que-bert/clock-radio/cad/Board Holder.step

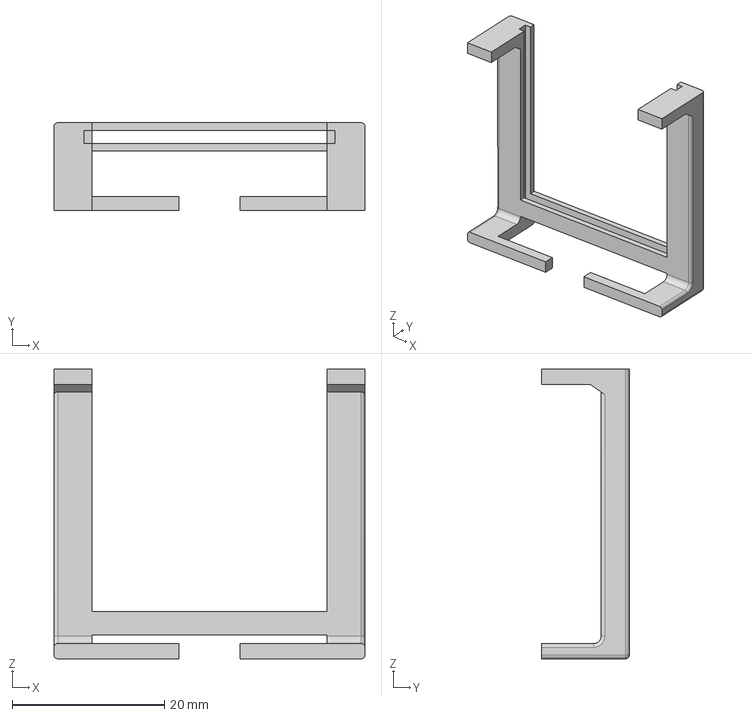
[picture p1: CAD file, 2026-07-31]
cad/Board Holder.step
40.8 x 11.5 x 38.0 mm
