que-bert/clock-radio/cad/Rat_Clock_Final.step

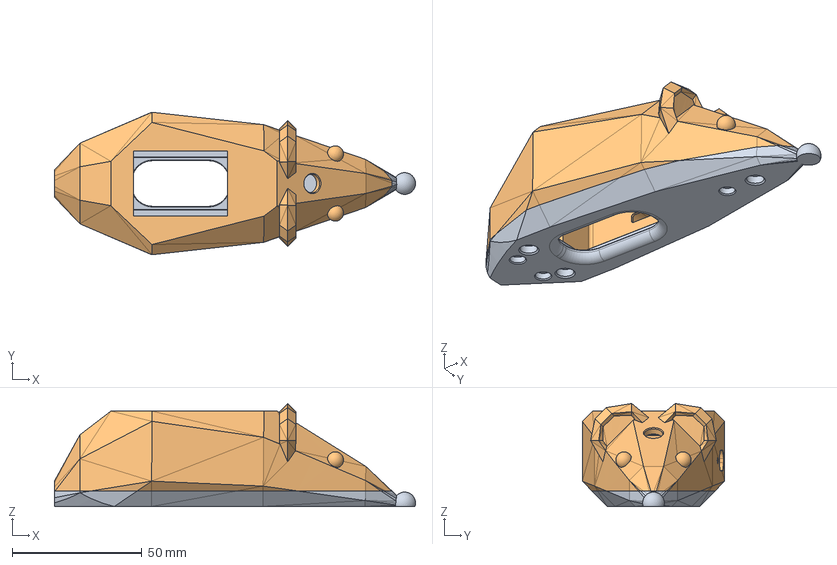
[picture p2: CAD file, 2026-07-31]
cad/Rat_Clock_Final.step
139.4 x 55.0 x 39.8 mm
