que-bert/clock-radio/kicad/clock-radio.kicad_pcb

## KiCad design kicad/clock-radio.kicad_pcb (2026-06-23)

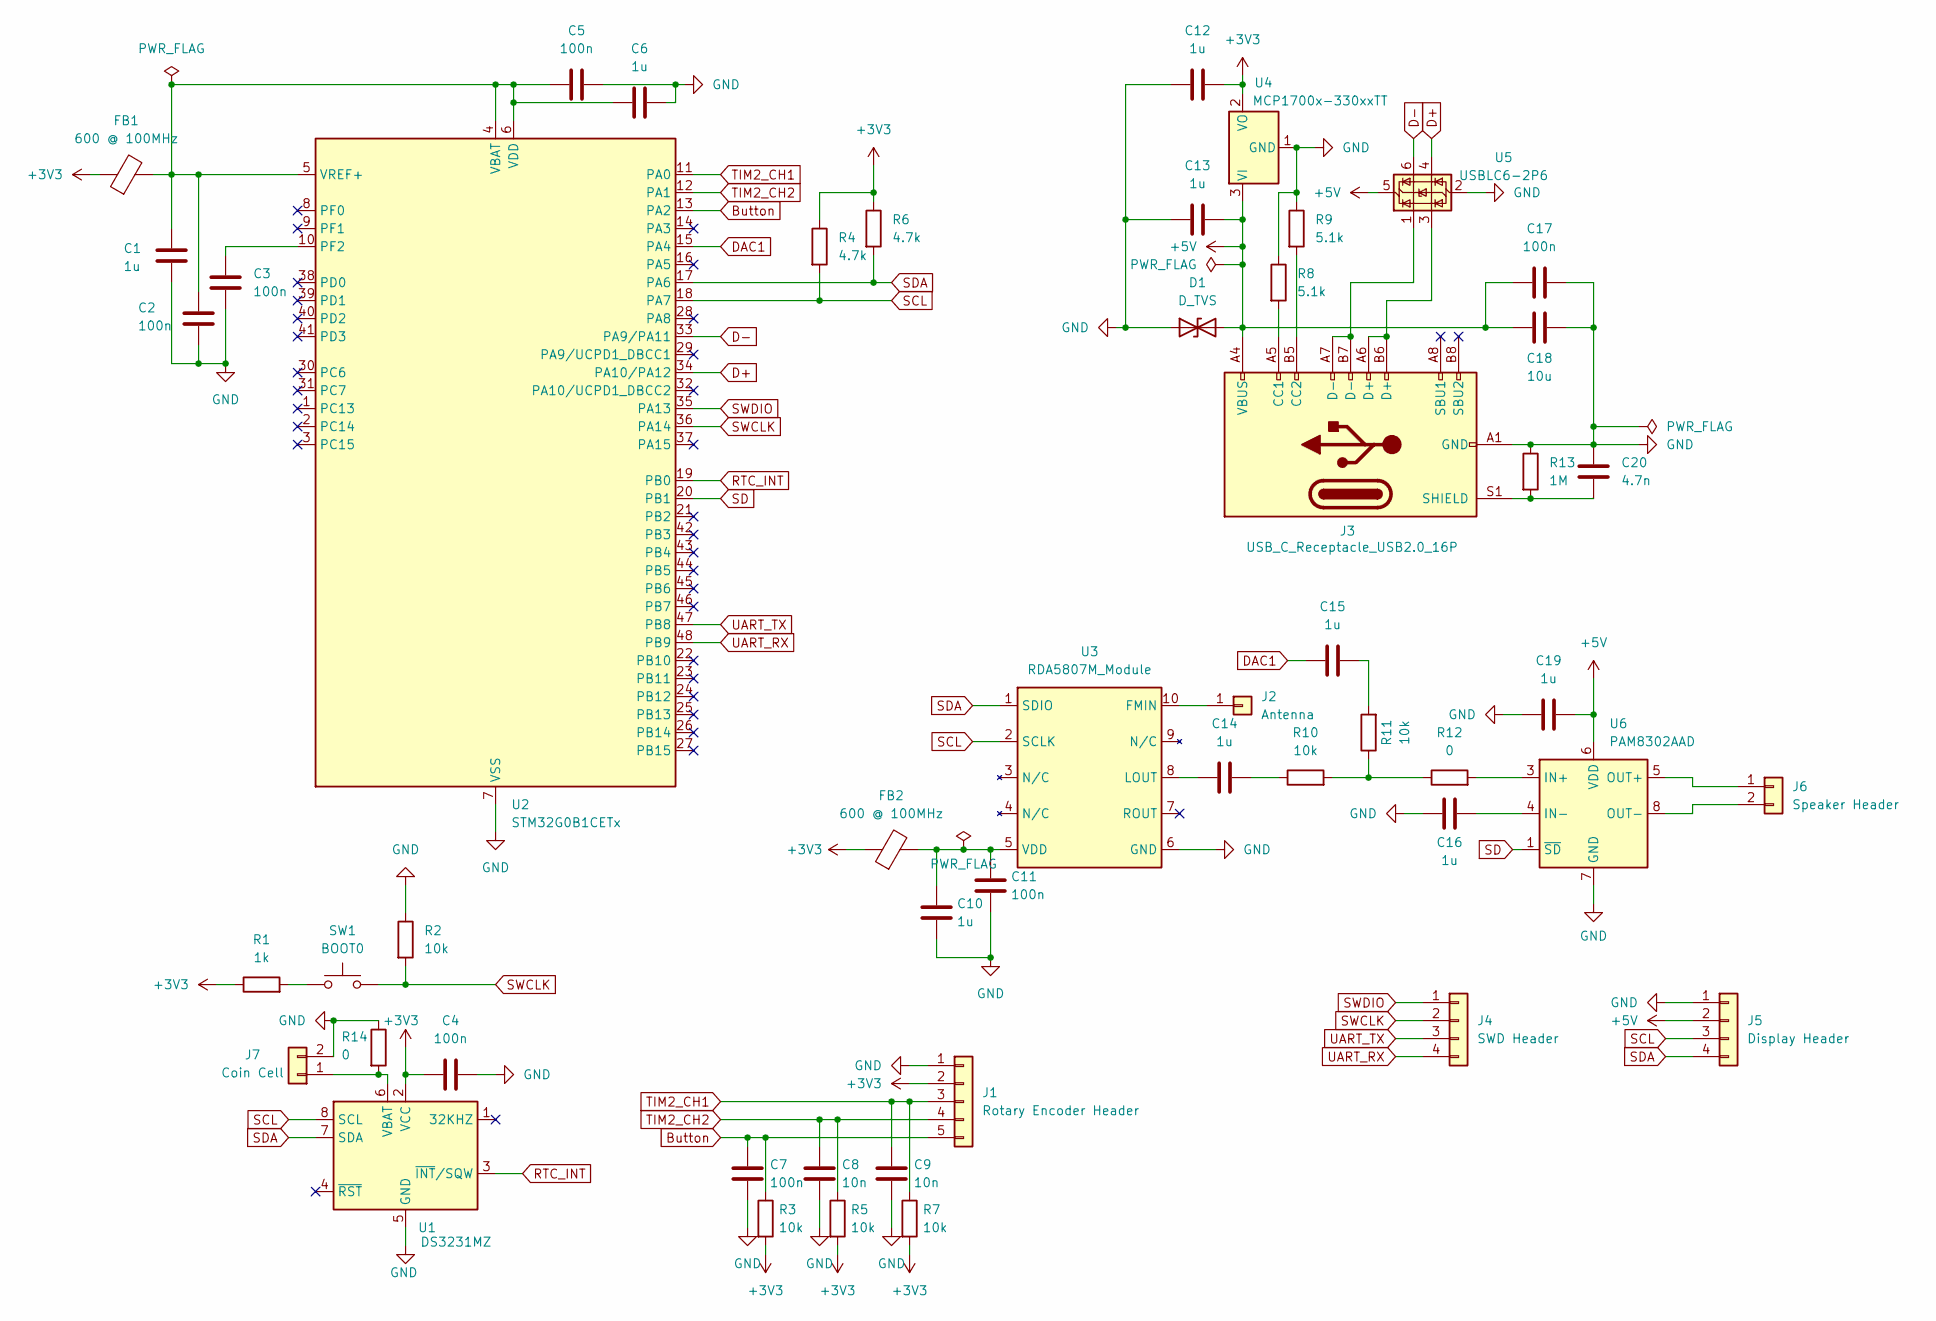
[picture p3: schematic clock-radio.kicad_sch]

Parts:
C1, C6, C10, C12, C13, C14, C15, C16, C19: 1u; C_0402_1005Metric_Pad0.74x0.62mm_HandSolder
C2, C3, C4, C5, C7, C11, C17: 100n; C_0402_1005Metric_Pad0.74x0.62mm_HandSolder
C8, C9: 10n; C_0402_1005Metric_Pad0.74x0.62mm_HandSolder
C18: 10u; C_0402_1005Metric_Pad0.74x0.62mm_HandSolder
C20: 4.7n; C_0402_1005Metric_Pad0.74x0.62mm_HandSolder
D1: D_TVS; D_SMA-SMB_Universal_Handsoldering
FB1, FB2: 600 @ 100MHz; C_0603_1608Metric_Pad1.08x0.95mm_HandSolder
J1: Rotary Encoder Header; PinSocket_1x05_P2.54mm_Vertical
J2: Antenna; SolderWire-0.75sqmm_1x01_D1.25mm_OD2.3mm
J3: USB_C_Receptacle_USB2.0_16P; USB_C_Receptacle_HCTL_HC-TYPE-C-16P-01A
J4: SWD Header; PinSocket_1x04_P2.54mm_Vertical
J5: Display Header; PinSocket_1x04_P2.54mm_Vertical
J6: Speaker Header; PinSocket_1x02_P2.54mm_Vertical
J7: Coin Cell; PinSocket_1x02_P2.54mm_Vertical
R1: 1k; R_0402_1005Metric_Pad0.72x0.64mm_HandSolder
R2, R3, R5, R7, R10, R11: 10k; R_0402_1005Metric_Pad0.72x0.64mm_HandSolder
R4, R6: 4.7k; R_0402_1005Metric_Pad0.72x0.64mm_HandSolder
R8, R9: 5.1k; R_0402_1005Metric_Pad0.72x0.64mm_HandSolder
R12, R14: 0; R_0402_1005Metric_Pad0.72x0.64mm_HandSolder
R13: 1M; R_0402_1005Metric_Pad0.72x0.64mm_HandSolder
SW1: BOOT0; SW_SPST_B3U-1000P
U1: DS3231MZ; SOIC-8_3.9x4.9mm_P1.27mm
U2: STM32G0B1CETx; LQFP-48_7x7mm_P0.5mm
U3: RDA5807M_Module; RDA5807M_Module_SM
U4: MCP1700x-330xxTT; SOT-23
U5: USBLC6-2P6; SOT-666
U6: PAM8302AAD; MSOP-8_3x3mm_P0.65mm

Connections:
+3V3: C4.1, C12.2, FB1.1, FB2.1, J1.2, R1.1, R3.2, R4.1, R5.2, R6.1, R7.2, U1.2 (VCC), U4.2 (VO); also elsewhere on the board
+5V: C13.2, C17.1, C18.1, C19.2, D1.2 (A2), J3.A4 (VBUS), J3.A9 (VBUS), J3.B4 (VBUS), J3.B9 (VBUS), J5.2, U4.3 (VI), U5.5 (VBUS), U6.6 (VDD)
Button: C7.1, J1.5, R3.1, U2.13 (PA2)
D+: U2.34 (PA10/PA12), U5.4 (I/O2)
D-: U2.33 (PA9/PA11), U5.6 (I/O1)
DAC1: C15.1, U2.15 (PA4)
GND: C1.1, C2.1, C3.1, C4.2, C5.2, C6.2, C7.2, C8.2, C9.2, C10.2, C11.2, C12.1, C13.1, C16.2, C17.2, C18.2, C19.1, C20.1, D1.1 (A1), J1.1, J3.A1 (GND), J3.A12 (GND), J3.B1 (GND), J3.B12 (GND), J5.1, J7.2, R2.1, R8.1, R9.1, R13.1, R14.1, U1.5 (GND), U2.7 (VSS), U3.6 (GND), U4.1 (GND), U5.2 (GND), U6.7 (GND); also elsewhere on the board
unnamed: C14.2, R10.1
unnamed: C15.2, R11.2
unnamed: J2.1, U3.10 (FMIN)
unnamed: J3.A5 (CC1), R8.2
unnamed: J3.B5 (CC2), R9.2
unnamed: J3.A6 (D+), J3.B6 (D+), U5.3 (I/O2)
unnamed: J3.A7 (D-), J3.B7 (D-), U5.1 (I/O1)
unnamed: C20.2, J3.S1 (SHIELD), R13.2
unnamed: J6.1, U6.5 (OUT+)
unnamed: J6.2, U6.8 (OUT-)
unnamed: J7.1, R14.2, U1.6 (VBAT)
unnamed: R1.2, SW1.1
unnamed: R10.2, R11.1, R12.1
unnamed: C3.2, U2.10 (PF2)
unnamed: C1.2, C2.2, C5.1, C6.1, FB1.2, U2.4 (VBAT), U2.5 (VREF+), U2.6 (VDD)
unnamed: C14.1, U3.8 (LOUT)
unnamed: C10.1, C11.1, FB2.2, U3.5 (VDD)
unnamed: R12.2, U6.3 (IN+)
unnamed: C16.1, U6.4 (IN-)
RTC_INT: U1.3 (~INT/SQW), U2.19 (PB0)
SCL: J5.3, R4.2, U1.8 (SCL), U2.18 (PA7), U3.2 (SCLK)
SD: U2.20 (PB1), U6.1 (~SD)
SDA: J5.4, R6.2, U1.7 (SDA), U2.17 (PA6), U3.1 (SDIO)
SWCLK: J4.2, R2.2, SW1.2, U2.36 (PA14)
SWDIO: J4.1, U2.35 (PA13)
TIM2_CH1: C9.1, J1.3, R7.1, U2.11 (PA0)
TIM2_CH2: C8.1, J1.4, R5.1, U2.12 (PA1)
UART_RX: J4.4, U2.48 (PB9)
UART_TX: J4.3, U2.47 (PB8)

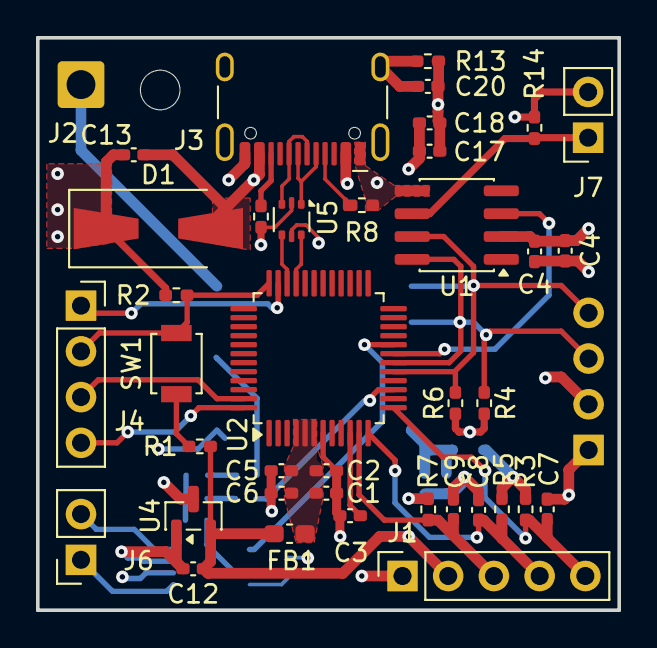
[picture p4: board clock-radio.kicad_pcb from above]

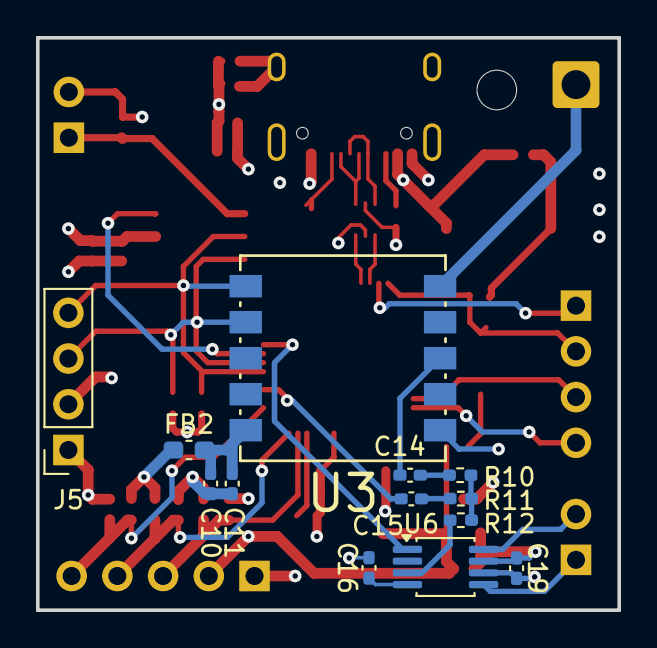
[picture p5: board clock-radio.kicad_pcb from below]

Board: 4 copper layers, 32.3 x 31.8 mm, 52 parts (13 on the bottom side), 36 nets.

Other parts of the board:
C4#2: 100n; C_0402_1005Metric_Pad0.74x0.62mm_HandSolder

Their connections:
+3V3: C4#2.2; also elsewhere on the board
GND: C4#2.1; also elsewhere on the board
