que-bert/clock-radio/firmware/Core/Src/main.c

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
/* Includes ------------------------------------------------------------------*/
#include "main.h"

/* USER CODE BEGIN Includes */
#include "ui.h"
#include "usb_device.h"
#include "console.h"
/* USER CODE END Includes */

DAC_HandleTypeDef hdac1;
DMA_HandleTypeDef hdma_dac1_ch1;

I2C_HandleTypeDef hi2c2;

TIM_HandleTypeDef htim2;
TIM_HandleTypeDef htim6;

UART_HandleTypeDef huart3;

PCD_HandleTypeDef hpcd_USB_DRD_FS;

void SystemClock_Config(void);
static void MX_GPIO_Init(void);
static void MX_DMA_Init(void);
static void MX_DAC1_Init(void);
static void MX_I2C2_Init(void);
static void MX_TIM2_Init(void);
static void MX_TIM6_Init(void);
static void MX_USART3_UART_Init(void);
static void MX_USB_DRD_FS_PCD_Init(void);
/* USER CODE BEGIN 0 */
/* Jump to the ROM bootloader (USB DFU). Callable from the running app
 * (console "dfu" command) as well as early boot: the USB peripheral is
 * force-reset so the bootloader finds virgin hardware even if the app
 * was enumerated, and IRQs are masked/cleared via NVIC, not PRIMASK -
 * the bootloader needs interrupts deliverable once it sets its own up. */
void dfu_jump(void)
{
  uint32_t boot_msp   = *(volatile uint32_t *)0x1FFF0000u;  /* system memory */
  uint32_t boot_entry = *(volatile uint32_t *)0x1FFF0004u;

  __HAL_RCC_USB_FORCE_RESET();
  __HAL_RCC_USB_RELEASE_RESET();
  HAL_RCC_DeInit();
  SysTick->CTRL = 0; SysTick->LOAD = 0; SysTick->VAL = 0;
  NVIC->ICER[0U] = 0xFFFFFFFFu;
  NVIC->ICPR[0U] = 0xFFFFFFFFu;
  __HAL_RCC_SYSCFG_CLK_ENABLE();
  __HAL_SYSCFG_REMAPMEMORY_SYSTEMFLASH();
  __set_MSP(boot_msp);
  ((void (*)(void))boot_entry)();
}

/* Enter the ROM bootloader when the encoder button is held at power-up.
 * Runs before peripheral init, so it configures the one pin it needs
 * itself. */
static void dfu_enter_if_button_held(void)
{
  GPIO_InitTypeDef gi = {0};
  __HAL_RCC_GPIOA_CLK_ENABLE();
  gi.Pin  = ENC_BUTTON_Pin;
  gi.Mode = GPIO_MODE_INPUT;
  gi.Pull = GPIO_PULLUP;
  HAL_GPIO_Init(ENC_BUTTON_GPIO_Port, &gi);

  HAL_Delay(50);                       /* pull-up settle + debounce */
  if (HAL_GPIO_ReadPin(ENC_BUTTON_GPIO_Port, ENC_BUTTON_Pin) != GPIO_PIN_RESET)
    return;

  dfu_jump();
}
/* USER CODE END 0 */

/**
  * @brief  The application entry point.
  * @retval int
  */
int main(void)
{

  /* USER CODE BEGIN 1 */
  /* After a dfu-util ":leave" the ROM bootloader jumps here with VTOR
   * still pointing at its own vector table, so every interrupt (SysTick,
   * USB, ...) would land in ROM code. Reclaim the vectors first. */
  SCB->VTOR = FLASH_BASE;
  /* USER CODE END 1 */

  /* MCU Configuration--------------------------------------------------------*/

  /* Reset of all peripherals, Initializes the Flash interface and the Systick. */
  HAL_Init();

  /* Configure the system clock */
  SystemClock_Config();

  /* USER CODE BEGIN SysInit */
  dfu_enter_if_button_held();
  /* USER CODE END SysInit */

  /* Initialize all configured peripherals */
  MX_GPIO_Init();
  MX_DMA_Init();
  MX_DAC1_Init();
  MX_I2C2_Init();
  MX_TIM2_Init();
  MX_TIM6_Init();
  MX_USART3_UART_Init();
  MX_USB_DRD_FS_PCD_Init();
  /* USER CODE BEGIN 2 */
  ui_init();
  MX_USB_Device_Init();        /* CDC command console on the USB port */
  /* USER CODE END 2 */

  /* Infinite loop */
  /* USER CODE BEGIN WHILE */
  while (1)
  {
    /* USER CODE END WHILE */

    /* USER CODE BEGIN 3 */
    ui_tick();
    console_tick();
  }
  /* USER CODE END 3 */
}

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
