que-bert/clock-radio/firmware/clock-radio.ioc

Mcu.UserName=STM32G0B1CETx
PA0.Signal=S_TIM2_CH1_ETR
PA1.Signal=S_TIM2_CH2
PA13.Signal=SYS_SWDIO
PA14-BOOT0.Signal=SYS_SWCLK
PA2.GPIO_Label=ENC_BUTTON
PA2.Signal=GPIO_Input
PA4.Signal=COMP_DAC11_group
PA6.Signal=I2C2_SDA
PA7.Signal=I2C2_SCL
PB0.GPIO_Label=RTC_INT
PB0.Signal=GPXTI0
PB1.GPIO_Label=AMP_SD
PB1.Signal=GPIO_Output
PB8.Signal=USART3_TX
PB9.Signal=USART3_RX
