que-bert/clock-radio/firmware/Core/Inc/main.h

#define ENC_BUTTON_Pin GPIO_PIN_2
#define ENC_BUTTON_GPIO_Port GPIOA
#define RTC_INT_Pin GPIO_PIN_0
#define RTC_INT_GPIO_Port GPIOB
#define RTC_INT_EXTI_IRQn EXTI0_1_IRQn
#define AMP_SD_Pin GPIO_PIN_1
#define AMP_SD_GPIO_Port GPIOB
