que-bert/clock-radio/firmware/App/Src/oled.c

/* oled.c - SH1106 driver (I2C, page-addressed) with a 5x7 font */
#include "oled.h"
#include "bsp.h"

#define SH1106_COL_OFFSET 2          /* 132-col RAM, 128 visible */

static uint8_t fb[OLED_W * OLED_H / 8];   /* 8 pages x 128 cols */

/* ---- 5x7 font, ASCII 0x20..0x7E, 5 column-bytes per glyph (LSB=top) ---- */
static const uint8_t font5x7[][5] = {
    {0x00,0x00,0x00,0x00,0x00}, /* sp */ {0x00,0x00,0x5F,0x00,0x00}, /* ! */
    {0x00,0x07,0x00,0x07,0x00}, /* " */  {0x14,0x7F,0x14,0x7F,0x14}, /* # */
    {0x24,0x2A,0x7F,0x2A,0x12}, /* $ */  {0x23,0x13,0x08,0x64,0x62}, /* % */
    {0x36,0x49,0x55,0x22,0x50}, /* & */  {0x00,0x05,0x03,0x00,0x00}, /* ' */
    {0x00,0x1C,0x22,0x41,0x00}, /* ( */  {0x00,0x41,0x22,0x1C,0x00}, /* ) */
    {0x14,0x08,0x3E,0x08,0x14}, /* * */  {0x08,0x08,0x3E,0x08,0x08}, /* + */
    {0x00,0x50,0x30,0x00,0x00}, /* , */  {0x08,0x08,0x08,0x08,0x08}, /* - */
    {0x00,0x60,0x60,0x00,0x00}, /* . */  {0x20,0x10,0x08,0x04,0x02}, /* / */
    {0x3E,0x51,0x49,0x45,0x3E}, /* 0 */  {0x00,0x42,0x7F,0x40,0x00}, /* 1 */
    {0x42,0x61,0x51,0x49,0x46}, /* 2 */  {0x21,0x41,0x45,0x4B,0x31}, /* 3 */
    {0x18,0x14,0x12,0x7F,0x10}, /* 4 */  {0x27,0x45,0x45,0x45,0x39}, /* 5 */
    {0x3C,0x4A,0x49,0x49,0x30}, /* 6 */  {0x01,0x71,0x09,0x05,0x03}, /* 7 */
    {0x36,0x49,0x49,0x49,0x36}, /* 8 */  {0x06,0x49,0x49,0x29,0x1E}, /* 9 */
    {0x00,0x36,0x36,0x00,0x00}, /* : */  {0x00,0x56,0x36,0x00,0x00}, /* ; */
    {0x08,0x14,0x22,0x41,0x00}, /* < */  {0x14,0x14,0x14,0x14,0x14}, /* = */
    {0x00,0x41,0x22,0x14,0x08}, /* > */  {0x02,0x01,0x51,0x09,0x06}, /* ? */
    {0x32,0x49,0x79,0x41,0x3E}, /* @ */  {0x7E,0x11,0x11,0x11,0x7E}, /* A */
    {0x7F,0x49,0x49,0x49,0x36}, /* B */  {0x3E,0x41,0x41,0x41,0x22}, /* C */
    {0x7F,0x41,0x41,0x22,0x1C}, /* D */  {0x7F,0x49,0x49,0x49,0x41}, /* E */
    {0x7F,0x09,0x09,0x09,0x01}, /* F */  {0x3E,0x41,0x49,0x49,0x7A}, /* G */
    {0x7F,0x08,0x08,0x08,0x7F}, /* H */  {0x00,0x41,0x7F,0x41,0x00}, /* I */
    {0x20,0x40,0x41,0x3F,0x01}, /* J */  {0x7F,0x08,0x14,0x22,0x41}, /* K */
    {0x7F,0x40,0x40,0x40,0x40}, /* L */  {0x7F,0x02,0x0C,0x02,0x7F}, /* M */
    {0x7F,0x04,0x08,0x10,0x7F}, /* N */  {0x3E,0x41,0x41,0x41,0x3E}, /* O */
    {0x7F,0x09,0x09,0x09,0x06}, /* P */  {0x3E,0x41,0x51,0x21,0x5E}, /* Q */
    {0x7F,0x09,0x19,0x29,0x46}, /* R */  {0x46,0x49,0x49,0x49,0x31}, /* S */
    {0x01,0x01,0x7F,0x01,0x01}, /* T */  {0x3F,0x40,0x40,0x40,0x3F}, /* U */
    {0x1F,0x20,0x40,0x20,0x1F}, /* V */  {0x3F,0x40,0x38,0x40,0x3F}, /* W */
    {0x63,0x14,0x08,0x14,0x63}, /* X */  {0x07,0x08,0x70,0x08,0x07}, /* Y */
    {0x61,0x51,0x49,0x45,0x43}, /* Z */  {0x00,0x7F,0x41,0x41,0x00}, /* [ */
    {0x02,0x04,0x08,0x10,0x20}, /* \ */  {0x00,0x41,0x41,0x7F,0x00}, /* ] */
    {0x04,0x02,0x01,0x02,0x04}, /* ^ */  {0x40,0x40,0x40,0x40,0x40}, /* _ */
    {0x00,0x01,0x02,0x04,0x00}, /* ` */  {0x20,0x54,0x54,0x54,0x78}, /* a */
    {0x7F,0x48,0x44,0x44,0x38}, /* b */  {0x38,0x44,0x44,0x44,0x20}, /* c */
    {0x38,0x44,0x44,0x48,0x7F}, /* d */  {0x38,0x54,0x54,0x54,0x18}, /* e */
    {0x08,0x7E,0x09,0x01,0x02}, /* f */  {0x0C,0x52,0x52,0x52,0x3E}, /* g */
    {0x7F,0x08,0x04,0x04,0x78}, /* h */  {0x00,0x44,0x7D,0x40,0x00}, /* i */
    {0x20,0x40,0x44,0x3D,0x00}, /* j */  {0x7F,0x10,0x28,0x44,0x00}, /* k */
    {0x00,0x41,0x7F,0x40,0x00}, /* l */  {0x7C,0x04,0x18,0x04,0x78}, /* m */
    {0x7C,0x08,0x04,0x04,0x78}, /* n */  {0x38,0x44,0x44,0x44,0x38}, /* o */
    {0x7C,0x14,0x14,0x14,0x08}, /* p */  {0x08,0x14,0x14,0x18,0x7C}, /* q */
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
};

static void cmd(uint8_t c)
{
    uint8_t buf[2] = {0x00, c};       /* 0x00 = command stream */
    HAL_I2C_Master_Transmit(&hi2c2, ADDR_SH1106, buf, 2, 50);
}

void oled_init(void)
{
    const uint8_t seq[] = {
        0xAE,             /* display off */
        0xD5,0x80,        /* clock divide */
        0xA8,0x3F,        /* multiplex = 64 */
        0xD3,0x00,        /* display offset 0 */
        0x40,             /* start line 0 */
        0xAD,0x8B,        /* DC-DC on (SH1106; unknown-cmd nop on SSD1306) */
        0x8D,0x14,        /* charge pump on (SSD1306; nop on SH1106) */
        0xA0,             /* segment remap off  \ together: panel mounted */
        0xC0,             /* COM scan inc       / rotated 180 in enclosure */
        0xDA,0x12,        /* COM pins */
        0x81,0x80,        /* contrast */
        0xD9,0x22,        /* pre-charge */
        0xDB,0x35,        /* VCOM deselect */
        0xA4,             /* resume from RAM */
        0xA6,             /* normal (not inverted) */
        0xAF              /* display on */
    };
    HAL_Delay(100);
    for (unsigned i = 0; i < sizeof(seq); i++) cmd(seq[i]);
    oled_clear();
    oled_update();
}

void oled_contrast(uint8_t v) { cmd(0x81); cmd(v); }

void oled_clear(void) { for (unsigned i = 0; i < sizeof(fb); i++) fb[i] = 0; }

void oled_set_pixel(int x, int y, bool on)
{
    if (x < 0 || x >= OLED_W || y < 0 || y >= OLED_H) return;
    uint8_t *p = &fb[(y / 8) * OLED_W + x];
    if (on) *p |=  (1 << (y & 7));
    else    *p &= ~(1 << (y & 7));
}

void oled_char(int x, int y, char c, bool inv)
{
    if (c < 0x20 || c > 0x7E) c = '?';
    const uint8_t *g = font5x7[c - 0x20];
    for (int col = 0; col < 6; col++) {
        uint8_t bits = (col < 5) ? g[col] : 0x00;
        if (inv) bits = ~bits;
        for (int row = 0; row < 8; row++)
            oled_set_pixel(x + col, y + row, (bits >> row) & 1);
    }
}

void oled_text(int x, int y, const char *s, bool inv)
{
    while (*s) { oled_char(x, y, *s++, inv); x += 6; }
}

void oled_text_big(int x, int y, const char *s)   /* 2x nearest-neighbour */
{
    while (*s) {
        char c = *s++;
        if (c < 0x20 || c > 0x7E) c = '?';
        const uint8_t *g = font5x7[c - 0x20];
        for (int col = 0; col < 6; col++) {
            uint8_t bits = (col < 5) ? g[col] : 0x00;
            for (int row = 0; row < 8; row++) {
                bool on = (bits >> row) & 1;
                oled_set_pixel(x + col*2,   y + row*2,   on);
                oled_set_pixel(x + col*2+1, y + row*2,   on);
                oled_set_pixel(x + col*2,   y + row*2+1, on);
                oled_set_pixel(x + col*2+1, y + row*2+1, on);
            }
        }
        x += 12;
    }
}

void oled_fill_row(int page, bool on)
{
    if (page < 0 || page > 7) return;
    for (int x = 0; x < OLED_W; x++) fb[page * OLED_W + x] = on ? 0xFF : 0x00;
}

uint32_t oled_dbg_max;                 /* worst single page-write, ms */

/* Pushing the whole frame in one go blocks the main loop ~70 ms, which is
 * long enough to make the UI feel dead (and used to eat button presses when
 * they were polled). oled_update() therefore only marks the frame dirty;
 * oled_pump() - called once per main-loop pass - sends ONE page (~9 ms), so
 * the loop stays responsive while a frame trickles out.
 *
 * A sweep, once started, always finishes all 8 pages; a new frame marked
 * mid-sweep only queues the next sweep. (Restarting at page 0 on every mark
 * starved the bottom pages whenever renders arrived faster than a sweep
 * drained - which happened when USB-audio interrupt load stretched the I2C
 * writes, freezing the lower half of the screen.) */
static uint8_t push_page = 8;          /* next page to send; 8 = idle */
static bool    frame_dirty;            /* a new frame awaits the next sweep */

void oled_update(void)
{
    frame_dirty = true;
}

bool oled_pump(void)
{
    if (push_page >= 8) {
        if (!frame_dirty) return false;
        frame_dirty = false;
        push_page = 0;                 /* begin a full sweep of the new frame */
    }
    uint32_t t0 = HAL_GetTick();
    uint8_t page = push_page;
    cmd(0xB0 | page);                                   /* page address */
    cmd(0x00 | (SH1106_COL_OFFSET & 0x0F));             /* low column   */
    cmd(0x10 | (SH1106_COL_OFFSET >> 4));               /* high column  */
    uint8_t line[1 + OLED_W];
    line[0] = 0x40;                                     /* data stream  */
    for (int x = 0; x < OLED_W; x++) line[1 + x] = fb[page * OLED_W + x];
    HAL_I2C_Master_Transmit(&hi2c2, ADDR_SH1106, line, sizeof(line), 100);
    push_page++;
    uint32_t dt = HAL_GetTick() - t0;
    if (dt > oled_dbg_max) oled_dbg_max = dt;
    return true;
}
