que-bert/clock-radio/firmware/App/Inc/ui.h

/* ui.h - clock-radio application: state machine, menus, rendering */
#ifndef UI_H
#define UI_H

#include <stdint.h>
#include <stdbool.h>

void ui_init(void);    /* init all peripherals/drivers + initial screen */
void ui_tick(void);    /* call continuously from the main loop */

/* software-interface hooks (console) - main-loop context only */
void ui_cmd_radio(bool on);
void ui_cmd_tune(uint32_t khz);
void ui_cmd_seek(bool up);
void ui_cmd_vol(uint8_t v);              /* 0..15 */
void ui_cmd_mute(bool m);
void ui_cmd_fmt24(bool f24);
void ui_cmd_alarm(int idx, int h, int m);
void ui_cmd_alarm_en(int idx, bool en);
void ui_cmd_alarm_sound(int idx, int snd);   /* 0-based */
void ui_cmd_alarm_vol(int idx, int vol);     /* 1..15 */
void ui_cmd_alarm_days(int idx, uint8_t mask); /* bit0=Sun..bit6=Sat; 0=daily */
void ui_cmd_snooze(uint8_t mins);            /* 1..15 */
void ui_cmd_tz2(int off_hours);              /* 0 = off, else -12..+14 */
void ui_cmd_usb_audio(bool en);              /* enable/disable USB speaker */
void ui_get_status(char *buf, int n);
uint32_t ui_dbg_ingap(void);                 /* worst input-poll gap, then reset */
uint32_t ui_dbg_rtcmax(void);                /* worst RTC read duration, then reset */
uint32_t ui_dbg_durmax(void);                /* worst ui_tick duration, then reset */
uint32_t ui_dbg_rendmax(void);               /* worst render() duration, then reset */
uint32_t ui_dbg_secmax(void);                /* worst 1 Hz block duration, then reset */

#endif /* UI_H */
