que-bert/clock-radio/(commit log)

2026-06-10 Initial import of clock-radio KiCad project
    [clock-radio.kicad_pcb, clock-radio.kicad_sch]
2026-06-11 Added decoupling capacitors and ferrite bead on radio module
    [clock-radio.kicad_sch]
2026-06-11 started pcb design
    [clock-radio.kicad_pcb, clock-radio.kicad_sch]
2026-06-15 updated pcb layout
    [clock-radio.kicad_pcb, clock-radio.kicad_sch]
2026-06-17 added coin cell
    [clock-radio.kicad_sch]
2026-06-20 connected all components and added in ground and power plane
    [clock-radio.kicad_pcb, clock-radio.kicad_sch]
2026-06-20 Check out antenna footprint
    [clock-radio.kicad_pcb]
2026-06-20 swapped layers
    [clock-radio.kicad_pcb, clock-radio.kicad_sch]
2026-06-20 Added m2 hole
    [clock-radio.kicad_pcb]
2026-06-20 Added gerber files
    [clock-radio-B_Cu.gbl, clock-radio-B_Mask.gbs, clock-radio-B_Paste.gbp, clock-radio-B_Silkscreen.gbo, clock-radio-Edge_Cuts.gm1, clock-radio-F_Cu.gtl, clock-radio-F_Mask.gts, clock-radio-F_Paste.gtp]
2026-06-23 updated cap
    [clock-radio-B_Cu.gbl, clock-radio-B_Mask.gbs, clock-radio-B_Paste.gbp, clock-radio-B_Silkscreen.gbo, clock-radio-Edge_Cuts.gm1, clock-radio-F_Cu.gtl, clock-radio-F_Mask.gts, clock-radio-F_Paste.gtp]
2026-07-28 Day-of-week alarms, USB speaker (composite CDC+UAC1), input/display fixes
    Alarms:
    - Per-alarm day-of-week mask (daily/weekdays/weekends/any combo), set via
    rotary editor (per-day checkbox picker), console (alarm N days SPEC) and
    web UI (7 day toggles per alarm); firing and next-alarm display honor it
    - Weekday computed from date (Sakamoto); settings slot widened 32->64 B (v5)
    - Quick alarm on/off: long-press an alarm row in the Alarm menu
    USB speaker:
    - Composite USB device: existing CDC console + UAC1 mono speaker
    (32 kHz, iso OUT EP3) in one hand-rolled class that delegates CDC
    verbatim to the stock ST class; IAD device descriptor
    - Fix CubeMX PMA layout: EP0 buffer at 0x14 overla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
    [audio.c, audio.h, bsp.h, console.c, input.c, input.h, oled.c, oled.h]
2026-07-31 Added cad files
    [Board Holder.step, Rat_Clock_Final.step]
